Jayanthan-Amalanathan/laser-cutting-and-engraving/material-selection-and-specifications.jpeg

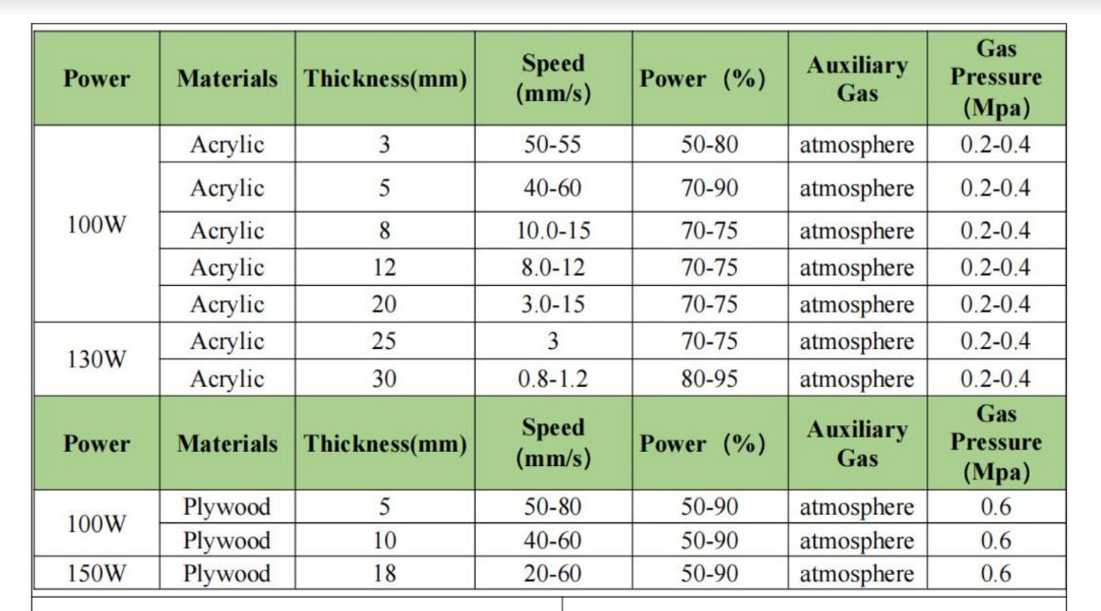
material-selection-and-specifications.jpeg
