Jayanthan-Amalanathan/laser-cutting-and-engraving/box.dxf

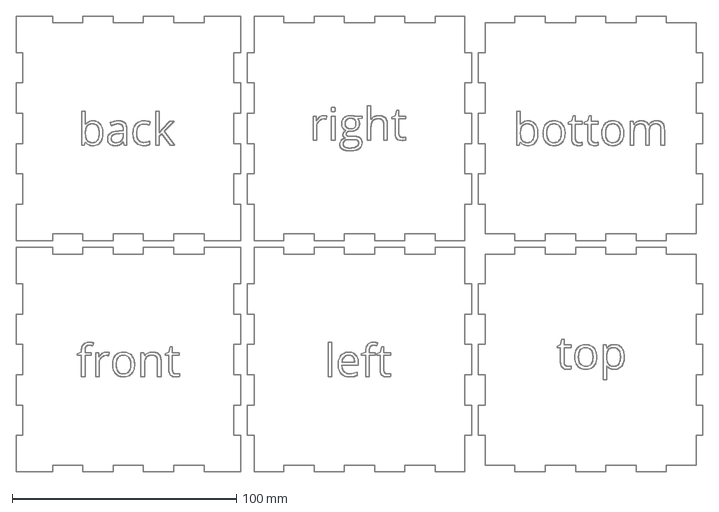
[picture p11: CAD file, 2022-05-27]
box.dxf
306.0 x 203.0 mm
