Jayanthan-Amalanathan/laser-cutting-and-engraving/Setting up your laser/TracingTest GCode-V2.xlsx

Sheet: Draw Lines
TracingTest Gcode Generator-V2
 | Draw 10 vertical Lines with Laser |  |  | Purpose
 | PARAMETERS | NOTE: PARAMETER VALUES ARE NOT CHECKED |  | To draw lines on the stock at varying speed and feed to determine what works best.
 | Power Start | 200 | Power for line 1 (1-1,000) | Instructions
 | Power Step | 33.3 |  | Set the line height and spacing as required.
 | Power End | 500 | Power for line 10 (1-1,000) | Set the laser power start and end, for each each line the power will be adjusted by the calculated power step.
 | Feed Start (mm/Min) | 300 | Feed for line 1 (1-1,000) | To keep a constant power for all lines set the start equal to the end.
 | Feed Step (mm/Min) | 0.0 |  | Set the feed rate start and end, adjusted the same as the power.
 | Feed End (mm/Min) | 300 | Feed for line 10 (1-1,000) | Select and copy the Gcode, just the green box, into a text editor such as notepad and save as a .nc file
 | Line Height(mm) | 10 |  | Before running the file check the Laser Focus, position the laser to the start and zero all the axes.
 | Line Spacing(mm) | 2 |  | The laser will return to the WCS origin after drawing the last line
 |  | Gcode | Meaning
 |  | $32=1 | Set Laser Mode On, if it's already set dont copy this
 |  | (TracingTest Gcode Generator-V2)
 |  | (Draw 10 vertical Lines with Laser)
 |  | (Power 200/33/500)
 |  | (Feed 300/0/300 mm/Min)
 |  | (Line Height 10, Spacing 2 mm)
 |  | G94 | Feed rate is units/minute
 |  | G17 | Select XY plane
 |  | G21 | Interpret all distances in mm
 |  | G90 | Set Absolute coordinate mode
 |  | G0 X0 Y0 | Go to the home (WCS) position.
 |  | G91 | Set Relative coordinate mode
 |  | M3 | Turn the laser on
 |  | (Draw lines)
 |  | G1 Y10 F300 S200 | Burn up
 |  | G0 X2 Y-10 | Position rapidly to the start of the next line
 |  | G1 Y10 F300 S233
 |  | G0 X2 Y-10
 |  | G1 Y10 F300 S266
 |  | G0 X2 Y-10
 |  | G1 Y10 F300 S300
 |  | G0 X2 Y-10
 |  | G1 Y10 F300 S333
 |  | G0 X2 Y-10
 |  | G1 Y10 F300 S366
 |  | G0 X2 Y-10
 |  | G1 Y10 F300 S400
 |  | G0 X2 Y-10
 |  | G1 Y10 F300 S433
 |  | G0 X2 Y-10
 |  | G1 Y10 F300 S466
 |  | G0 X2 Y-10
 |  | G1 Y10 F300 S500
 |  | G90
 |  | G0 X0 Y0 | Go to to home position, set Absolute Coordinate mode
 |  | M2 | Program end, laser off
 |  | (END OF PROGRAM)

Sheet: Draw Boxes
TracingTest Gcode Generator-V2
 | Laser engrave 10x1-5 Boxes |  |  | Purpose
 | PARAMETERS | NOTE: PARAMETER VALUES ARE NOT CHECKED |  | To draw boxes on the stock at varying speed and feed to determine what works best. Power is varied for each row.
 | Power Start | 150 | Power for row 1 (1-1,000) Adjusted for each row | Feed rate is varied for each column. Number of rows is variable from 1 to 5.
 | Power Step | 150.0 | 1-5 columns of boxes | Instructions
 | Power End | 750 | Power for row x (1-1,000) Adjusted for each row | Set the box height, width and spacing as required.
 | Feed Start (mm/Min) | 100 | Feed Rate for box 1 (1-1,000) Adjusted for each column | Set the laser power start and end, for each each row the power will be adjusted by the calculated power step.
 | Feed Step (mm/Min) | 100.0 | 10 boxes per row | If only one row is selected - it won't change. To keep a constant power for all rows set the start equal to the end.
 | Feed End (mm/Min) | 1000 | Feed Rate for box 10 (1-1,000) Adjusted for each column | Set the feed rate start and end, adjusted for each column.
 | Box Height(mm) | 5 |  | Select and copy the Gcode, just the green box, into a text editor such as notepad and save as a .nc file
 | Box Width (mm) | 2 |  | Before running the file check the Laser Focus, position the laser to the start and zero all the axes.
 | Box Spacing (mm) | 3 |  | The laser will return to the WCS origin after drawing the last row of boxes.
 | Box Rows | 5 | 1 to 5
 |  | Gcode | Meaning
 |  | $32=1 | Set Laser Mode On, if it's already set dont copy this
 |  | (TracingTest Gcode Generator-V2) | Comment
 |  | (Laser engrave 10x1-5 Boxes) | Comment
 |  | (Power-Row 150/150/750) | Comment
 |  | (Feed-Col 100/100/1000 mm/Min) | Comment
 |  | (Box Height 5, Width 2, Spacing 3 mm. Rows 5) | Comment
 |  | G94 | Feed rate is units/minute
 |  | G17 | Select XY plane
 |  | G21 | Interpret all distances in mm
 |  | G90 | Set Absolute coordinate mode
 |  | G0 X0 Y32 | Go to the start position. (WCS origin is bottom left)
 |  | G91 | Set Relative coordinate mode
 |  | M3 | Turn the laser on
 |  | (Draw 10 boxes in a row varying Feed) | Comment
 |  | S150 | Set Speed for this Row
 |  | G1 Y5 F100 | Burn up setting Feedrate for box
 |  | G1 X2 | Right
 |  | G1 Y-5 | Down
 |  | G1 X-2 | Left
 |  | G0 X5 | Position rapidly to the start of the next box
 |  | G1 Y5 F200 | Burn up setting Feedrate for box
 |  | G1 X2 | Right
 |  | G1 Y-5 | Down
 |  | G1 X-2 | Left
 |  | G0 X5 | Position rapidly to the start of the next box
 |  | G1 Y5 F300 | Burn up setting Feedrate for box
 |  | G1 X2 | Right
 |  | G1 Y-5 | Down
 |  | G1 X-2 | Left
 |  | G0 X5 | Position rapidly to the start of the next box
 |  | G1 Y5 F400 | Burn up setting Feedrate for box
 |  | G1 X2 | Right
 |  | G1 Y-5 | Down
 |  | G1 X-2 | Left
 |  | G0 X5 | Position rapidly to the start of the next box
 |  | G1 Y5 F500 | Burn up setting Feedrate for box
 |  | G1 X2 | Right
 |  | G1 Y-5 | Down
 |  | G1 X-2 | Left
 |  | G0 X5 | Position rapidly to the start of the next box
 |  | G1 Y5 F600 | Burn up setting Feedrate for box
 |  | G1 X2 | Right
 |  | G1 Y-5 | Down
 |  | G1 X-2 | Left
 |  | G0 X5 | Position rapidly to the start of the next box
 |  | G1 Y5 F700 | Burn up setting Feedrate for box
 |  | G1 X2 | Right
 |  | G1 Y-5 | Down
 |  | G1 X-2 | Left
 |  | G0 X5 | Position rapidly to the start of the next box
 |  | G1 Y5 F800 | Burn up setting Feedrate for box
 |  | G1 X2 | Right
 |  | G1 Y-5 | Down
 |  | G1 X-2 | Left
 |  | G0 X5 | Position rapidly to the start of the next box
 |  | G1 Y5 F900 | Burn up setting Feedrate for box
 |  | G1 X2 | Right
 |  | G1 Y-5 | Down
 |  | G1 X-2 | Left
 |  | G0 X5 | Position rapidly to the start of the next box
 |  | G1 Y5 F1000 | Burn up setting Feedrate for box
 |  | G1 X2 | Right
 |  | G1 Y-5 | Down
 |  | G1 X-2 | Left
 |  | G0 X-45 Y-8 | Position to start of the next row or WCS home at end
 |  | (Start Next Row)
 |  | S300
 |  | G1 Y5 F100
 |  | G1 X2
 |  | G1 Y-5
 |  | G1 X-2
 |  | G0 X5
 |  | G1 Y5 F200
 |  | G1 X2
 |  | G1 Y-5
 |  | G1 X-2
 |  | G0 X5
 |  | G1 Y5 F300
 |  | G1 X2
 |  | G1 Y-5
 |  | G1 X-2
 |  | G0 X5
 |  | G1 Y5 F400
 |  | G1 X2
 |  | G1 Y-5
 |  | G1 X-2
 |  | G0 X5
 |  | G1 Y5 F500
 |  | G1 X2
 |  | G1 Y-5
 |  | G1 X-2
 |  | G0 X5
 |  | G1 Y5 F600
 |  | G1 X2
 |  | G1 Y-5
 |  | G1 X-2
 |  | G0 X5
 |  | G1 Y5 F700
 |  | G1 X2
 |  | G1 Y-5
 |  | G1 X-2
 |  | G0 X5
 |  | G1 Y5 F800
 |  | G1 X2
 |  | G1 Y-5
 |  | G1 X-2
 |  | G0 X5
 |  | G1 Y5 F900
 |  | G1 X2
 |  | G1 Y-5
 |  | G1 X-2
 |  | G0 X5
 |  | G1 Y5 F1000
 |  | G1 X2
 |  | G1 Y-5
 |  | G1 X-2
 |  | G0 X-45 Y-8
 |  | (Start Next Row)
 |  | S450
 |  | G1 Y5 F100
 |  | G1 X2
 |  | G1 Y-5
 |  | G1 X-2
 |  | G0 X5
 |  | G1 Y5 F200
 |  | G1 X2
 |  | G1 Y-5
 |  | G1 X-2
 |  | G0 X5
 |  | G1 Y5 F300
 |  | G1 X2
 |  | G1 Y-5
 |  | G1 X-2
 |  | G0 X5
 |  | G1 Y5 F400
 |  | G1 X2
 |  | G1 Y-5
 |  | G1 X-2
 |  | G0 X5
 |  | G1 Y5 F500
 |  | G1 X2
 |  | G1 Y-5
 |  | G1 X-2
 |  | G0 X5
 |  | G1 Y5 F600
 |  | G1 X2
 |  | G1 Y-5
 |  | G1 X-2
 |  | G0 X5
 |  | G1 Y5 F700
 |  | G1 X2
 |  | G1 Y-5
 |  | G1 X-2
 |  | G0 X5
 |  | G1 Y5 F800
 |  | G1 X2
 |  | G1 Y-5
 |  | G1 X-2
 |  | G0 X5
 |  | G1 Y5 F900
 |  | G1 X2
 |  | G1 Y-5
 |  | G1 X-2
 |  | G0 X5
 |  | G1 Y5 F1000
 |  | G1 X2
 |  | G1 Y-5
 |  | G1 X-2
 |  | G0 X-45 Y-8
 |  | (Start Next Row)
 |  | S600
 |  | G1 Y5 F100
 |  | G1 X2
 |  | G1 Y-5
 |  | G1 X-2
 |  | G0 X5
 |  | G1 Y5 F200
 |  | G1 X2
 |  | G1 Y-5
 |  | G1 X-2
 |  | G0 X5
 |  | G1 Y5 F300
 |  | G1 X2
 |  | G1 Y-5
 |  | G1 X-2
 |  | G0 X5
 |  | G1 Y5 F400
 |  | G1 X2
 |  | G1 Y-5
 |  | G1 X-2
 |  | G0 X5
 |  | G1 Y5 F500
 |  | G1 X2
 |  | G1 Y-5
 |  | G1 X-2
 |  | G0 X5
 |  | G1 Y5 F600
 |  | G1 X2
 |  | G1 Y-5
 |  | G1 X-2
 |  | G0 X5
 |  | G1 Y5 F700
 |  | G1 X2
 |  | G1 Y-5
 |  | G1 X-2
 |  | G0 X5
 |  | G1 Y5 F800
 |  | G1 X2
 |  | G1 Y-5
 |  | G1 X-2
 |  | G0 X5
 |  | G1 Y5 F900
 |  | G1 X2
 |  | G1 Y-5
 |  | G1 X-2
 |  | G0 X5
 |  | G1 Y5 F1000
 |  | G1 X2
 |  | G1 Y-5
 |  | G1 X-2
 |  | G0 X-45 Y-8
 |  | (Start Next Row)
 |  | S750
 |  | G1 Y5 F100
 |  | G1 X2
 |  | G1 Y-5
 |  | G1 X-2
 |  | G0 X5
 |  | G1 Y5 F200
 |  | G1 X2
 |  | G1 Y-5
 |  | G1 X-2
 |  | G0 X5
 |  | G1 Y5 F300
 |  | G1 X2
 |  | G1 Y-5
 |  | G1 X-2
 |  | G0 X5
 |  | G1 Y5 F400
 |  | G1 X2
 |  | G1 Y-5
 |  | G1 X-2
 |  | G0 X5
 |  | G1 Y5 F500
 |  | G1 X2
 |  | G1 Y-5
 |  | G1 X-2
 |  | G0 X5
 |  | G1 Y5 F600
 |  | G1 X2
 |  | G1 Y-5
 |  | G1 X-2
 |  | G0 X5
 |  | G1 Y5 F700
 |  | G1 X2
 |  | G1 Y-5
 |  | G1 X-2
 |  | G0 X5
 |  | G1 Y5 F800
 |  | G1 X2
 |  | G1 Y-5
 |  | G1 X-2
 |  | G0 X5
 |  | G1 Y5 F900
 |  | G1 X2
 |  | G1 Y-5
 |  | G1 X-2
 |  | G0 X5
 |  | G1 Y5 F1000
 |  | G1 X2
 |  | G1 Y-5
 |  | G1 X-2
 |  | G0 G90 X0 Y0
 |  | M2
 |  | (END OF PROGRAM)

Sheet: Focus Test
TracingTest Gcode Generator-V2
 | Focus Test - Draw 11 lines with a Z axis step |  |  | Purpose
 | PARAMETERS | NOTE: PARAMETER VALUES ARE NOT CHECKED |  | To verify the focussing of the laser. 11 vertical lines are drawn moving the Z axis in between each.
 | Laser Power | 200 | Power for the test lines (1-1,000) | If the focus is correct the centre line will be the best and those on each side should become fainter.
 | Power for marks | 350 | Power for the reference marks (1-1,000) | This needs a carefull setting of the speed and feed values.
 | Feed (mm/Min) | 300 |  | Instructions
 | Line Height(mm) | 10 |  | Set the line height and spacing as required.
 | Line Spacing(mm) | 2 |  | Set the laser power for the test lines, power for the reference marks and a common feed rate.
 | Z Step (+=Up) | 1 | Amount the Z axis is moved between each line | Set the Z axis step between each line, the Z axis is adjusted so that the centre line will be at Z0 and moving out
 |  |  |  | the lines will be +/- the Z step so the effects of the focus can be seen.
 |  |  |  | NOTE: Make sure there is sufficient vertical travel available on the Z axis to account for the movement, you will
 |  |  |  | almost certainly need to slide the laser up a few mm if you have mounted it according to my suggestions.
 |  |  |  | Select and copy the Gcode, just the green box, into a text editor such as notepad and save as a .nc file
 |  |  |  | Before running the file check the Laser Focus, position the laser to the start and zero all the axes.
 |  | Gcode | Meaning | The laser will return to the WCS origin after drawing the last line
 |  | $32=1 | Set Laser Mode On, if it's already set dont copy this
 |  | (TracingTest Gcode Generator-V2)
 |  | (Focus Test - Draw 11 lines with a Z axis step)
 |  | (Power for Lines 200, Feed 300)
 |  | (Power for reference marks 350, Feed 300)
 |  | (Line Height 10, Spacing 2, Z Step 1 mm)
 |  | G94 | Feed rate is units/minute
 |  | G17 | Select XY plane
 |  | G21 | Interpret all distances in mm
 |  | G90 | Set Absolute Coordinate mode
 |  | G0 X0 Y0 | Go to the home (WCS) position. Leave Z unchanged.
 |  | G91 | Set Relative Coordinate mode
 |  | M3 | Turn the laser on
 |  | F300 | Set the Feed rate to xxx mm/min.
 |  | S350 | Set the laser power for the marks
 |  | (Draw Reference Marks) | First Draw reference lines
 |  | G1 Y1 | Draw short line up
 |  | G0 X2 Y-1 | Position rapidly to the start of the next line, Spindle Off
 |  | G1 Y1
 |  | G0 X2 Y-1
 |  | G1 Y1
 |  | G0 X2 Y-1
 |  | G1 Y1
 |  | G0 X2 Y-1
 |  | G1 Y1
 |  | G0 X2 Y-2 | Middle line, make longer
 |  | G1 Y2 | Middle line, make longer
 |  | G0 X2 Y-1
 |  | G1 Y1
 |  | G0 X2 Y-1
 |  | G1 Y1
 |  | G0 X2 Y-1
 |  | G1 Y1
 |  | G0 X2 Y-1
 |  | G1 Y1
 |  | G0 X2 Y-1
 |  | G1 Y1
 |  | G90
 |  | G0 X0 Y2 | Go to start position for sample lines
 |  | G91 | Use Relative Positioning from here
 |  | G0 Z-5 | Set Z Axis start
 |  | S200 | Set the laser power for the lines
 |  | G1 Y10 | Draw line
 |  | G0 X2 Y-10 Z1 | Position to next moving up a step on the Z axis
 |  | G1 Y10
 |  | G0 X2 Y-10 Z1
 |  | G1 Y10
 |  | G0 X2 Y-10 Z1
 |  | G1 Y10
 |  | G0 X2 Y-10 Z1
 |  | G1 Y10
 |  | G0 X2 Y-10 Z1
 |  | G1 Y10
 |  | G0 X2 Y-10 Z1
 |  | G1 Y10
 |  | G0 X2 Y-10 Z1
 |  | G1 Y10
 |  | G0 X2 Y-10 Z1
 |  | G1 Y10
 |  | G0 X2 Y-10 Z1
 |  | G1 Y10
 |  | G0 X2 Y-10 Z1
 |  | G1 Y10
 |  | G0 Z-5 | Set Z Axis back to starting position
 |  | G90 | Set Absolute Coordinate mode
 |  | G0 X0 Y0 | Go to to home position
 |  | M2 | Program end, laser off
 |  | (END OF PROGRAM)

Sheet: Acceleration Test
TracingTest Gcode Generator-V2
 | Acceleration Test |  |  | Purpose
 | PARAMETERS | NOTE: PARAMETER VALUES ARE NOT CHECKED |  | To verify the effects of altering the acceleration values in Grbl and to explore the limits | List of values for Laser/Spindle
 | Laser/Spindle | Laser | Use a Spindle or Laser, drop down box | This is set to work with both a laser and a spindle, probably with a V-Bit so the lines can still be seen. | Laser
 | Accel mm/sec/sec | 5000 | $120-122 acceleration values, all the same | NOTE: This draws a single box because Grbl (Quite sensibly) hates $ commands within the middle of a Gcode file. | Spindle
 | Laser Power | 750 | (1-1000) | Instructions
 | Feed (mm/Min) | 1000 | (1-1000) | Select either a Laser or a spindle, some other options are only needed when using a spindle.
 | N/A - Spindle Only | 250 | Plunge Rate, only used for Spindle (1-1,000) | Select the acceleration value for the Grbl $120-122 parameters.
 | Outer Box Size (mm) | 20 |  | Set the laser power/Spindle speed for the lines and feed rate. I suggest using the max feed rate possible
 | Circle Dia (mm) | 9 |  | Set the box size, options are given for the overall box size and the size of the interior circle.
 | Box Spacing (mm) | 5 | mm between boxes. If > 0 end on next box start else WCS. | Set the spacing between boxes, if Zero then the bit/laser will be positioned back to the WCS origin, if not then
 | N/A - Spindle Only | 5 | Retract height, only used for Spindle | the position will be back to the WCS origin.
 | N/A - Spindle Only | 1 | Depth of cut, only used for Spindle | Select and copy the Gcode, just the green box, into a text editor such as notepad and save as a .nc file
 |  |  |  | Before running the file check the Laser Focus, position the laser to the start and zero all the axes.
 |  | Gcode | Meaning | At the end if the box spacing is not Zero the position will be ready at the start of the next box but WILL NOT set
 |  | $32=1 | Set Laser Mode On/Off, if it's already set dont copy this | the Origin, if you want to draw another box after this one you will need to zero the origin before re running.
 |  | $120=5000 | Set Acceleration for the X axis
 |  | $121=5000 | Set Acceleration for the Y axis
 |  | $122=5000 | Set Acceleration for the Z axis
 |  | (TracingTest Gcode Generator-V2)
 |  | (Acceleration Test)
 |  | (Draw a 'complex' shape using a Laser)
 |  | (Box Size 20, Circle Dia 9, Spacing 5mm)
 |  | (Acceleration 5000 mm/sec/sec)
 |  | (Laser Power 750)
 |  | G94 | Feed rate is units/minute
 |  | G17 | Select XY plane
 |  | G21 | Interpret all distances in mm
 |  | G90
 |  |  | SPINDLE ONLY Retract above WCS position
 |  | G0 X0 Y0 | Go to the home (WCS) position X and Y axes
 |  | G91 | Use Relative Positioning from here
 |  | M3 | Turn the laser/Spindle on
 |  | F1000 | Set the Feed rate
 |  | S750 | Set the spindle Speed
 |  |  | SPINDLE ONLY Lower Spindle into stock
 |  | G1 X20 | Draw Square (Bottom)
 |  | G1 Y20 | (Right)
 |  | G1 X-20 | (Top)
 |  | G1 Y-20 | (Left)
 |  |  | SPINDLE ONLY Raise Spindle above the stock
 |  | G0 Y20 | Position to V start top left
 |  |  | SPINDLE ONLY Lower Spindle into stock
 |  | G1 X10 Y-20 | Draw V \
 |  | G1 X10 Y20 | Draw V /
 |  |  | SPINDLE ONLY Raise Spindle above the stock
 |  | G0 X-20 Y-20 | Position to ^ bottom left
 |  |  | SPINDLE ONLY Lower Spindle into stock
 |  | G1 X10 Y20 | Draw ^ /
 |  | G1 X10 Y-20 | Draw ^ \
 |  |  | SPINDLE ONLY Raise Spindle above the stock
 |  | G0 X-20 Y20 | Position to top left
 |  |  | SPINDLE ONLY Lower Spindle into stock
 |  | G1 X20 Y-20 | Draw Diagonal \
 |  |  | SPINDLE ONLY Raise Spindle above the stock
 |  | G0 Y20 | Position to top right
 |  |  | SPINDLE ONLY Lower Spindle into stock
 |  | G1 X-20 Y-20 | Draw Diagonal /
 |  |  | SPINDLE ONLY Raise Spindle above the stock
 |  | G0 X5.5 Y10 | Position to circle start centre LHS
 |  |  | SPINDLE ONLY Lower Spindle into stock
 |  | G2 I4.5 X0 Y0 | Draw Circle 9mm Dia
 |  |  | SPINDLE ONLY Raise Spindle above the stock
 |  | G90 | Absolute Coordinate Mode
 |  | G0 Y0 Z0 X25 | Position for next or WCS Origin
 |  | M2 | Program End, Spindle Off
 |  | (END OF PROGRAM)
