Jayanthan-Amalanathan/laser-cutting-and-engraving/(commit log)

2021-05-14 Laser engraving files
    [TracingTest GCode-V2.xlsx]
2022-05-27 Add samples for the cutting and engraving
    [box.dxf]
